adityaanand7982-droid/Project-Mote/PCB/PCB image.pdf

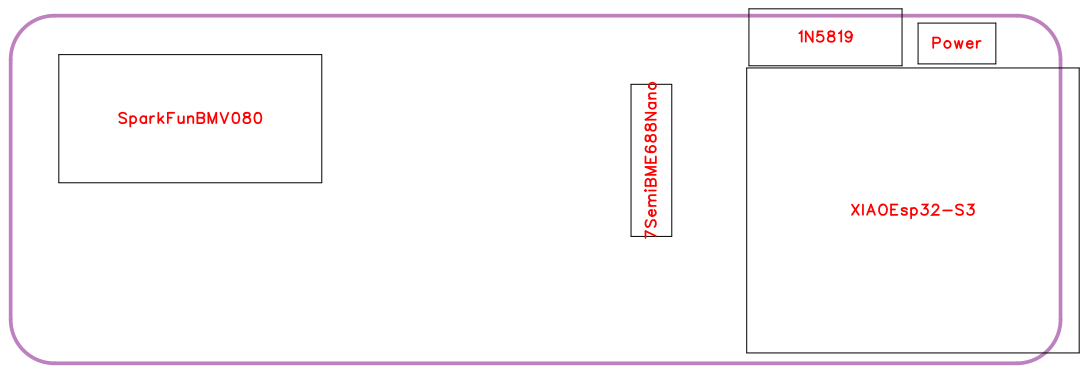
[picture p1: page 1]

No. | Quantity | Comment | Designator | Footprint | Value | Manufacturer Part | Manufacturer | Supplier Part | Supplier | Category | Primary Category
1 | 1 | 1N5819 | 1N5819 | DO-41_BD2. 4-L4.7-P8.70 -D0.9-RD | | 1N5819 | R+O(宏嘉诚 ) | C54795756 | LCSC | Diodes:Schot tky Diodes | Diodes
2 | 1 | 1x4 2.54mm Pitch 10mm Lead Length Female Header | 7SemiBME688Nano | 1x8 2.54mm Pitch 10mm Lead Length Female Header | | SSW-108-03-T-S | Samtec
3 | 1 | 2.54mm间距 针长19mm 2P排针 | Power | HDR-TH_2P-P2.54_C990 0022687 | | 2.54mm间距 针长19mm 2P排针 | | C990002268 7 | LCSC
4 | 1 | SparkFun -BMV080 | SparkFunBMV080 | CONN-TH_P Z2.54-1X7P-ZW
5 | 1 | XIAO ESP32-S3 | XIAOEsp32-S3 | XIAO ESP32-S3 | | 113991114 | Seeed Studio | 713-1139911 14 | Mouser

Secondary Category | Pin Count | Name | Device | 3D Model Title | LCSC Stock | JLCPCB Stock
Schottky Diodes | 2 | 1N5819 | 1N5819_C54 795756 | DO-41_D2.4-L4.7-P8.70 | | 24900
| 4 | 1x4 2.54mm Pitch 10mm Lead Length Female Header | 1x4 2.54mm Pitch 10mm Lead Length Female Header | | 24900
| 2 | 2.54mm间距 针长19mm 2P排针 | 2.54mm间距 针长19mm 2P排针 | HDR-TH_2P-P2.54_C990 0022687 | | 0
| 7 | | SparkFun -BMV080 | | 24900
| 14 | XIAO ESP32-S3 | XIAO ESP32-S3 | XIAO-ESP32 S3 v3 | | 0

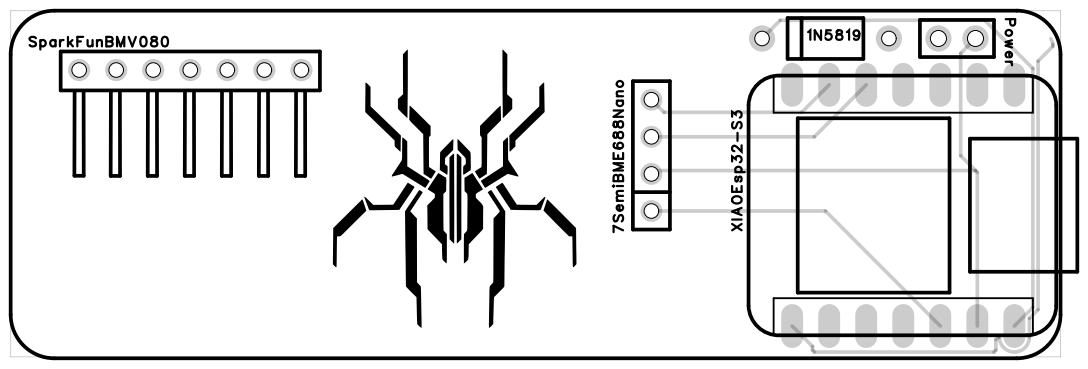
[picture p2: page 5]

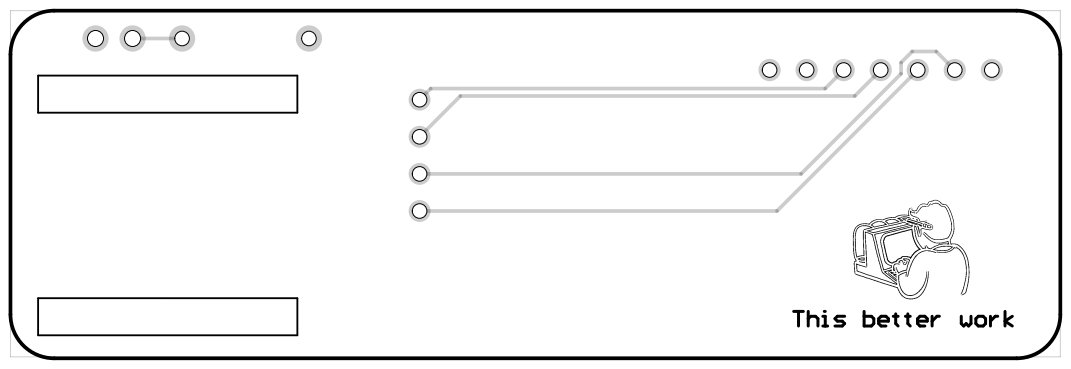
[picture p3: page 6]
