adityaanand7982-droid/Project-Mote/PCB/PCB image.png

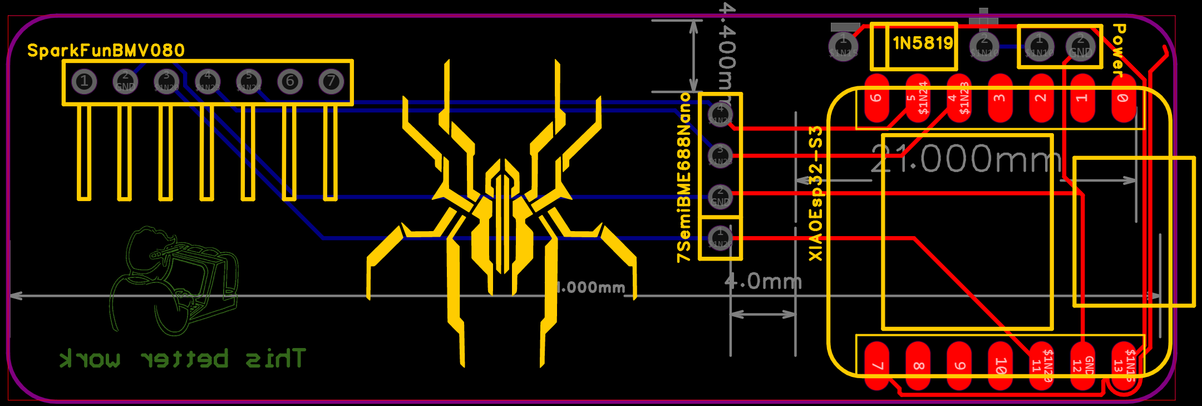
PCB/PCB image.png
