adityaanand7982-droid/Project-Mote/PCB/Schematic.png

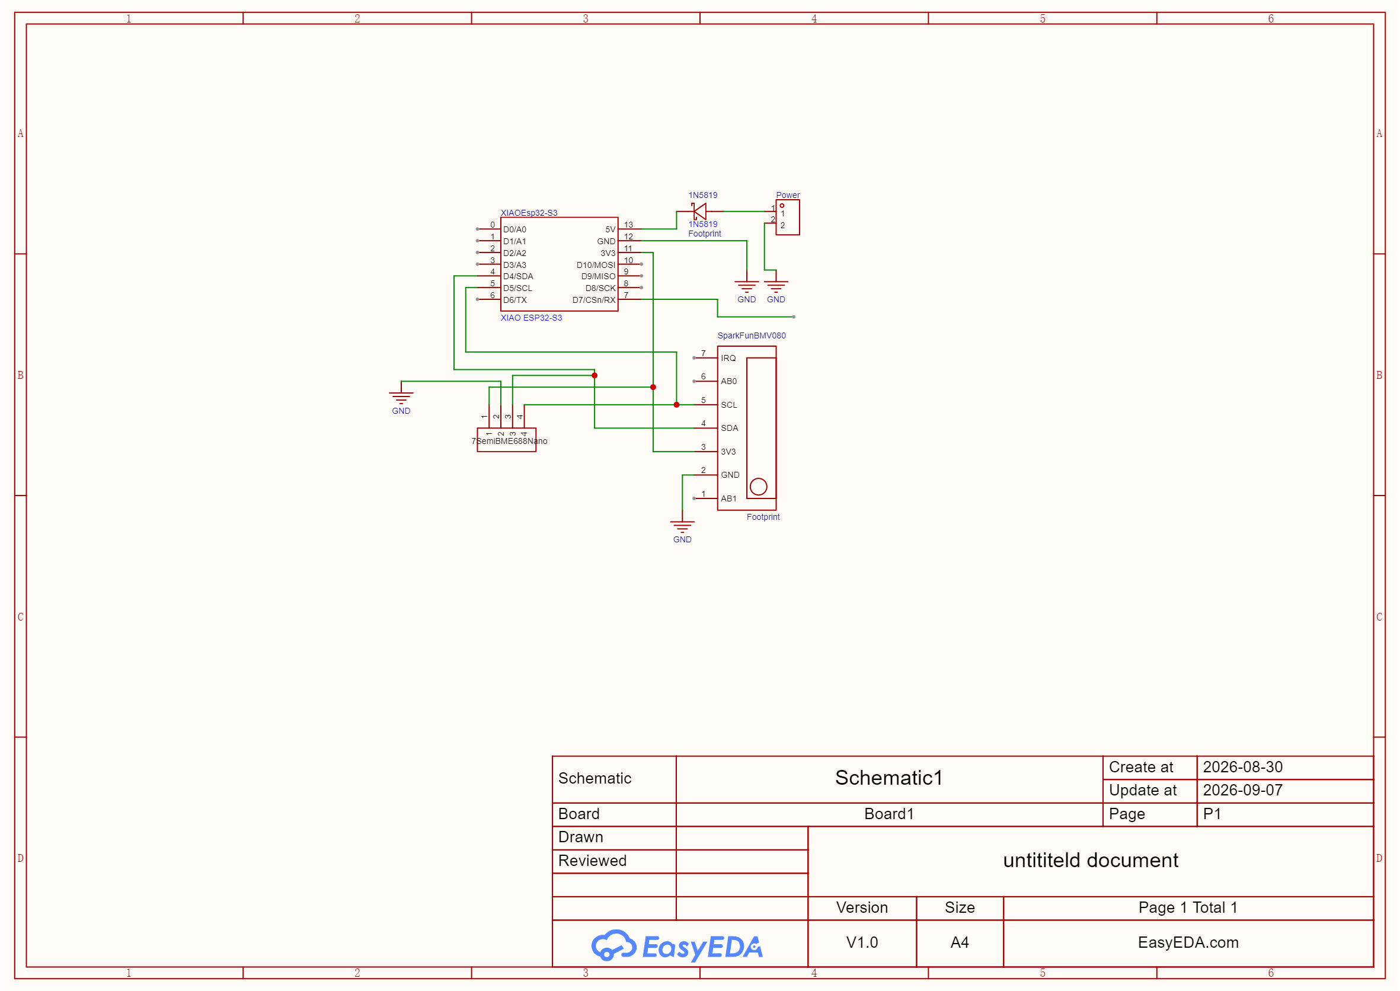
PCB/Schematic.png
