adityaanand7982-droid/Project-Mote/PCB/PCB design part in EasyEDA.csv

No. | Quantity | Comment | Designator | Footprint | Value | Manufacturer Part | Manufacturer | Supplier Part | Supplier | Category | Primary Category | Secondary Category | Pin Count | Name | Device | 3D Model Title | LCSC Stock | JLCPCB Stock
1 | 1 | 1N5819 | 1N5819 | DO-41_BD2.4-L4.7-P8.70-D0.9-RD |  | 1N5819 | R+O(宏嘉诚) | C54795756 | LCSC | Diodes:Schottky Diodes | Diodes | Schottky Diodes | 2 | 1N5819 | 1N5819_C54795756 | DO-41_D2.4-L4.7-P8.70 |  | 24940
2 | 1 | 1x4 2.54mm Pitch 10mm Lead Length Female Header | 7SemiBME688Nano | 1x8 2.54mm Pitch 10mm Lead Length Female Header |  | SSW-108-03-T-S | Samtec |  |  |  |  |  | 4 | 1x4 2.54mm Pitch 10mm Lead Length Female Header | 1x4 2.54mm Pitch 10mm Lead Length Female Header |  | 24940
3 | 1 | 2.54mm间距 针长19mm 2P排针 | Power | HDR-TH_2P-P2.54_C9900022687 |  | 2.54mm间距 针长19mm 2P排针 |  | C9900022687 | LCSC |  |  |  | 2 | 2.54mm间距 针长19mm 2P排针 | 2.54mm间距 针长19mm 2P排针 | HDR-TH_2P-P2.54_C9900022687 |  | 0
4 | 1 | SparkFun - BMV080 | SparkFunBMV080 | CONN-TH_PZ2.54-1X7P-ZW |  |  |  |  |  |  |  |  | 7 |  | SparkFun - BMV080 |  | 24940
5 | 1 | XIAO ESP32-S3 | XIAOEsp32-S3 | XIAO ESP32-S3 |  | 113991114 | Seeed Studio | 713-113991114 | Mouser |  |  |  | 14 | XIAO ESP32-S3 | XIAO ESP32-S3 | XIAO-ESP32S3 v3 |  | 0
