adityaanand7982-droid/Project-Mote/CAD/Part 1(Frame)/Part  1.step

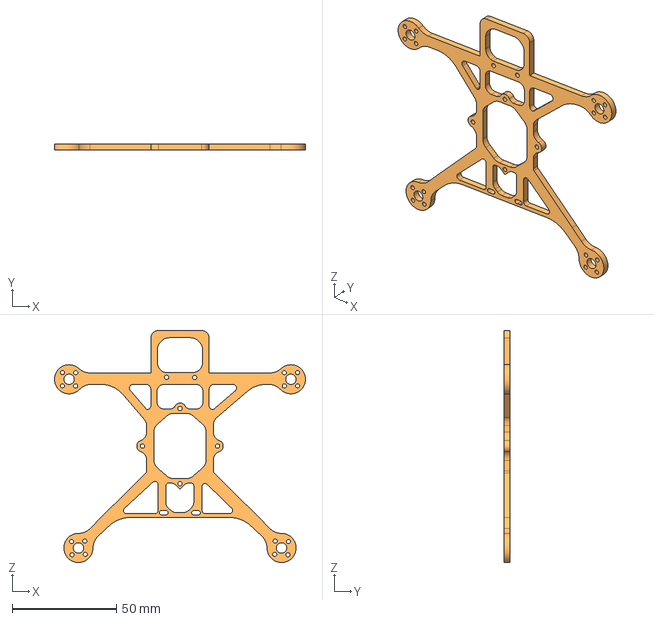
[picture p6: CAD file, 2026-09-08]
CAD/Part 1(Frame)/Part 1.step
120.6 x 3.00 x 111.5 mm
