adityaanand7982-droid/Project-Mote/CAD/Part 2(Pod)/Pod(updated).step

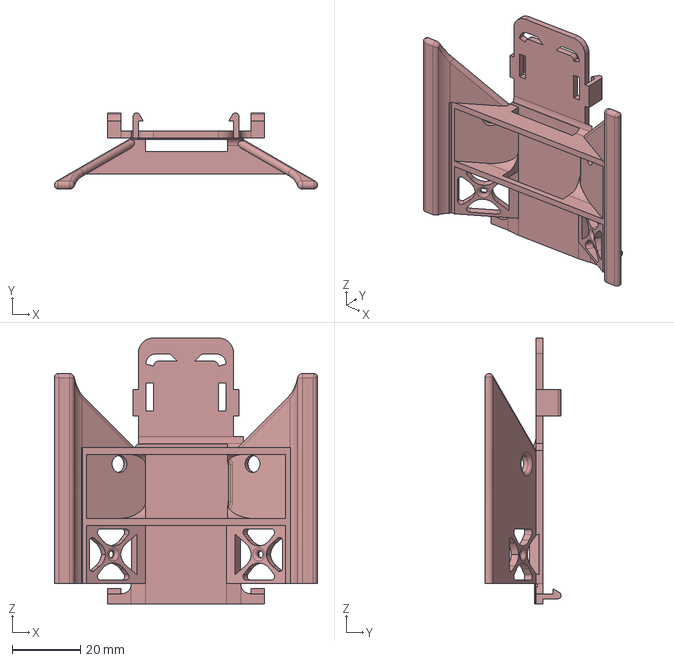
[picture p7: CAD file, 2026-09-19]
CAD/Part 2(Pod)/Pod(updated).step
77.1 x 22.4 x 78.0 mm
