adityaanand7982-droid/Project-Mote/CAD/Part 3(Battry Encloser)/1S/Part Studio 1 (1).step

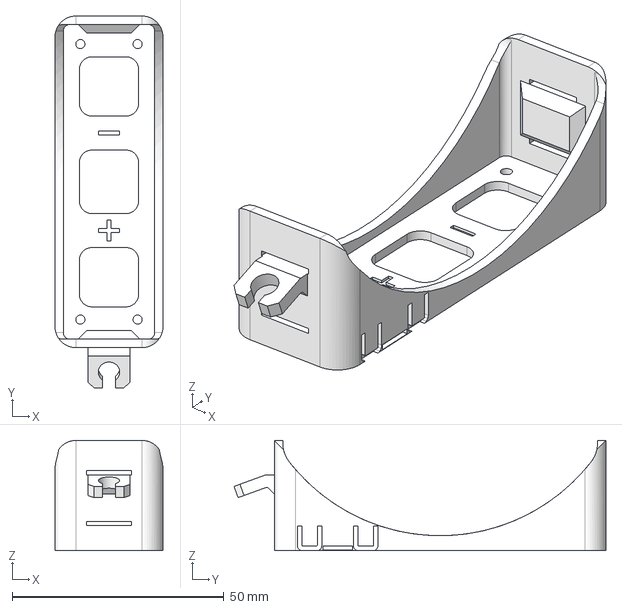
[picture p8: CAD file, 2026-09-08]
CAD/Part 3(Battry Encloser)/1S/Part Studio 1 (1).step
25.5 x 87.8 x 26.0 mm
