adityaanand7982-droid/Project-Mote/CAD/Part 3(Battry Encloser)/2S/2s Battery b.step

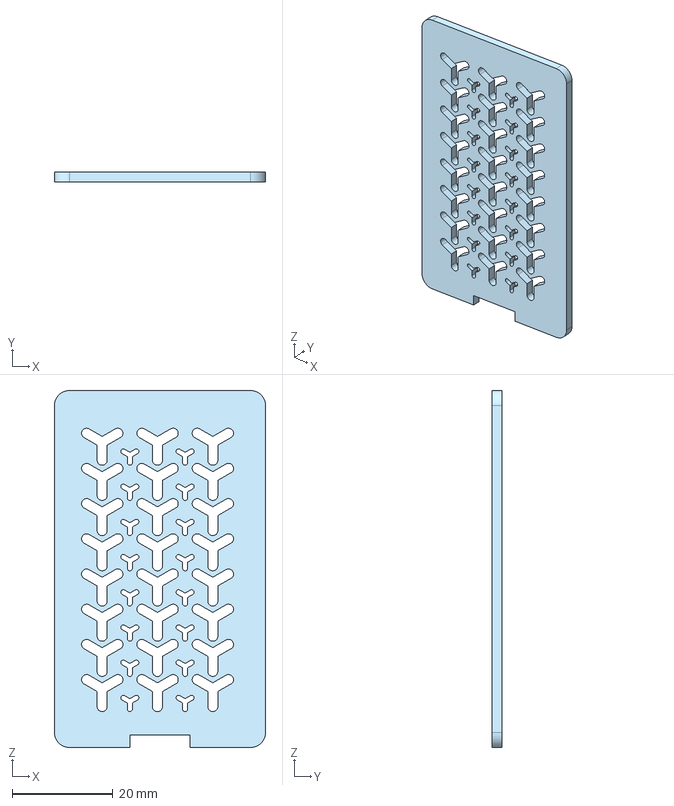
[picture p9: CAD file, 2026-09-18]
CAD/Part 3(Battry Encloser)/2S/2s Battery b.step
42.0 x 2.00 x 71.0 mm
