adityaanand7982-droid/Project-Mote/CAD/Part 4(Camera Mount)/Camera encloser.step

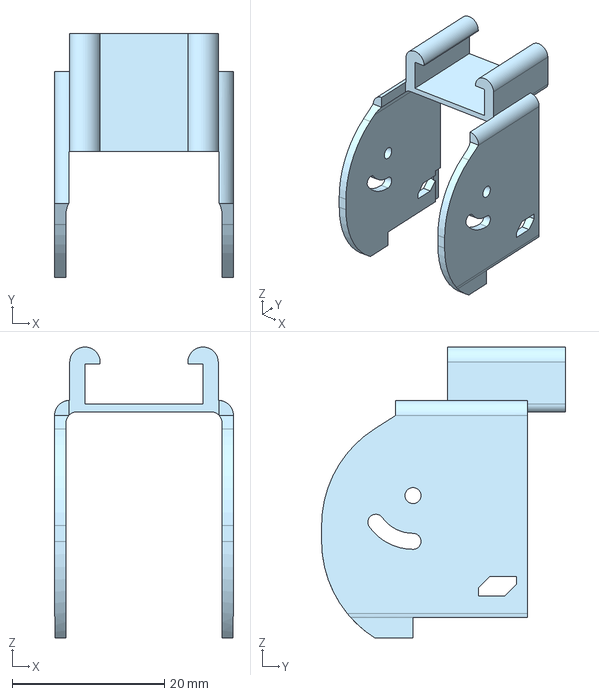
[picture p10: CAD file, 2026-09-18]
CAD/Part 4(Camera Mount)/Camera encloser.step
23.5 x 32.0 x 38.2 mm
