adityaanand7982-droid/Project-Mote/CAD/Part 2(Pod)/Part 2.3mf

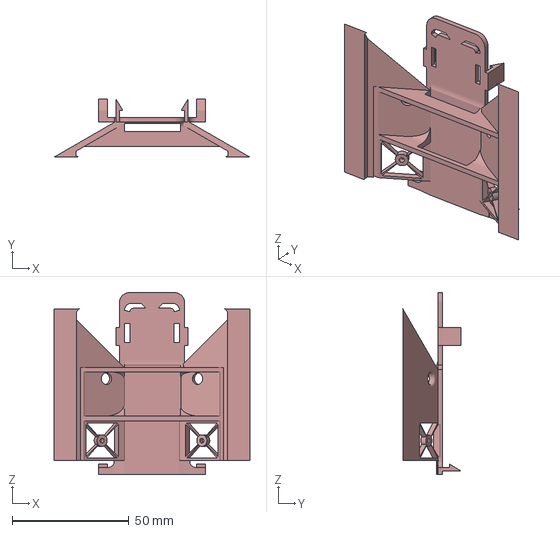
[picture p11: CAD file, 2026-09-08]
CAD/Part 2(Pod)/Part 2.3mf
84.0 x 25.0 x 78.0 mm
