adityaanand7982-droid/Project-Mote/CAD/Part 3(Battry Encloser)/2S/2s Battery.step

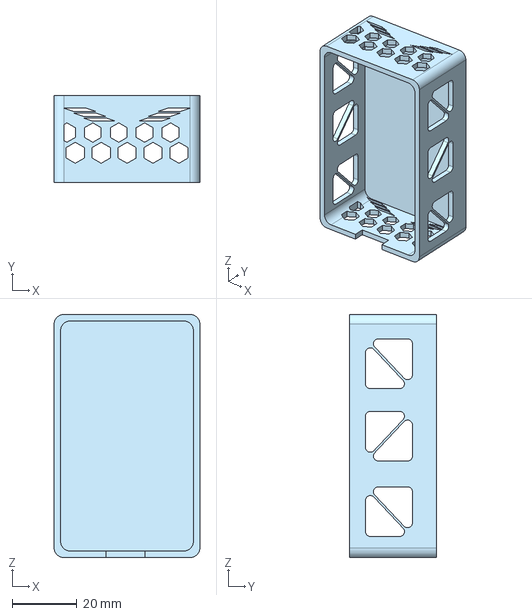
[picture p12: CAD file, 2026-09-18]
CAD/Part 3(Battry Encloser)/2S/2s Battery.step
45.0 x 27.0 x 75.0 mm
