adityaanand7982-droid/Project-Mote/(list of files, cad)

Other CAD files:
CAD/Part 3(Battry Encloser)/1S/Part 3(1S)21700.3mf
CAD/Part 4(Camera Mount)/Part 4(Camera Mount).3mf
CAD/Part 3(Battry Encloser)/2S/Part 3(b).3mf
CAD/Part 3(Battry Encloser)/2S/Part 3(a).3mf
CAD/Part 2(Pod)/Part 2.stl
CAD/Part 3(Battry Encloser)/1S/Part 3(1S) 21700.stl
CAD/Part 3(Battry Encloser)/2S/Part 3(a).stl
CAD/Part 3(Battry Encloser)/2S/Part 3(b).stl
CAD/Part 4(Camera Mount)/Part 4(Camera Mount).stl
