adityaanand7982-droid/Project-Mote/PCB/Schematic.pdf

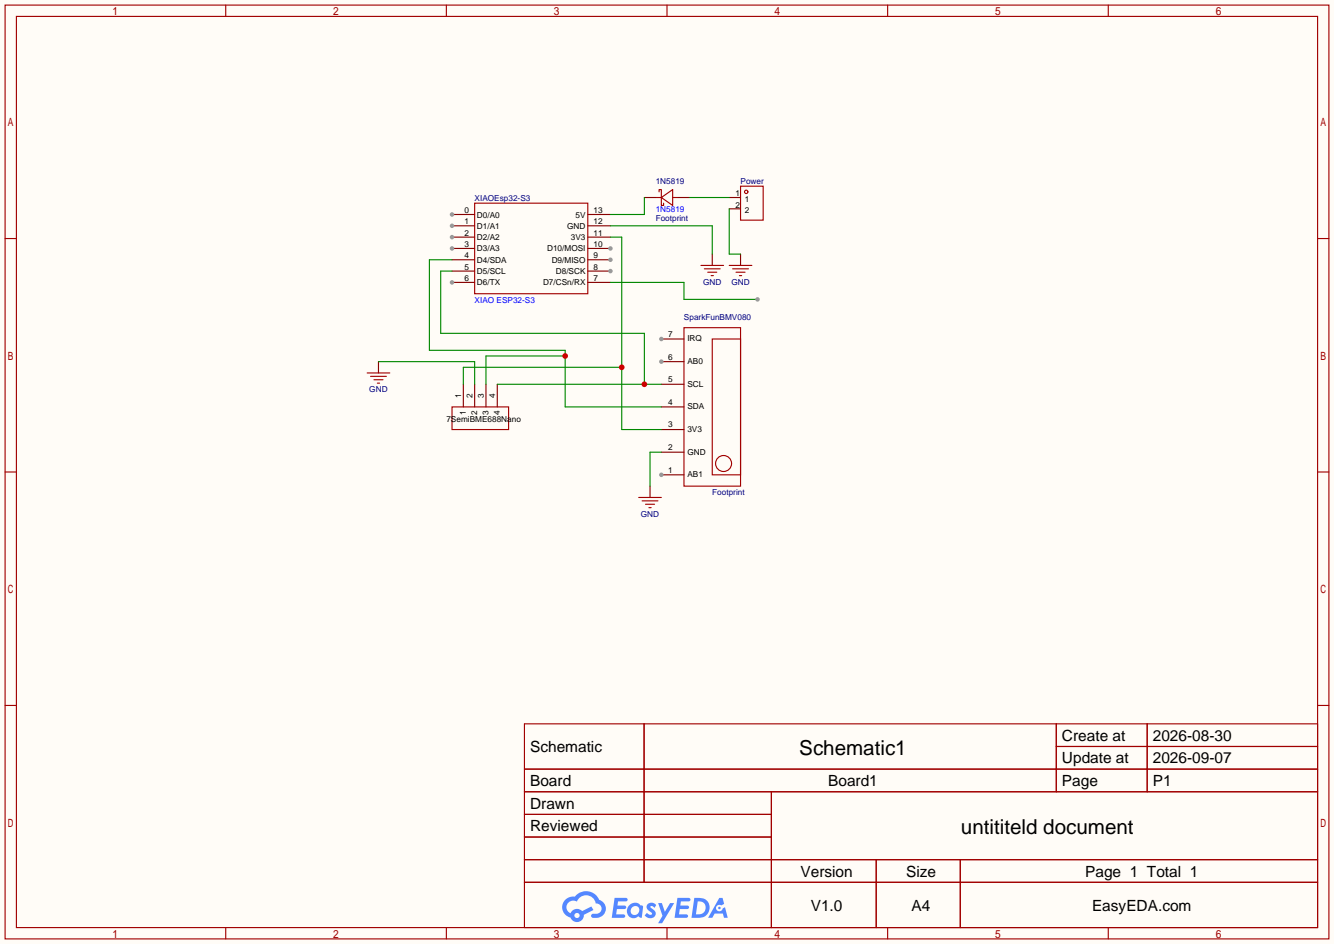
[picture p13: page 1]

Schematic | Schematic1 | Create at | 2026-08-30

Update at | 2026-09-07

Board | Board1 | Page | P1
Drawn | | untititeld document
Reviewed

Version | Size | Page 1 Total 1
V1.0 | A4 | EasyEDA.com
