adityaanand7982-droid/Project-Mote/(commit log)

2026-09-07 Project Mote
    Added schematics image section to README.
2026-09-09 pick snd plsce
    [PickAndPlace_PCB1.xlsx]
2026-09-09 README for avionics and custom PCB details
    This README provides an overview of the avionics and custom PCB for the Project-Mote payload, including hardware specifications, design specifications, and manufacturing files.
2026-09-15 README of CAD
2026-09-15 README of PCB
2026-09-18 Updated verson of pod
    [POD (1).step]
2026-09-18 Create BOM
2026-09-19 Main Bill of materials
    [BOM - Sheet1.csv]
2026-09-19 Rename BOM - Sheet1.csv to BOM/BOM.csv
    [BOM.csv]
